OpenAirCgn/openairnode-hw/README.md

# OpenAir Hardware Plattform

This repository contains the Kicad schematics and board layouts for the
OpenAir sensor plattform, as well as the bill of materials.

Schematics

## Versions

- 1.4 changed voltage regulator footprint (IC3), to a more common pinout,
  removed MICS sensor
