OpenAirCgn/openairnode-hw/openair2_BOM.ods

 |  |  |  |  |  |  |  |  |  |  |  | Units:
 |  |  |  |  |  |  |  |  |  |  |  | 17
Qty | Reference(s) | Value | Footprint | Manuf | PN | Source | Source # | Source € | Source @ | Remarks | Cost/unit | Needed | Avail | Needed | Cost/all | Order | Cost order |  | Avail 12.1.21 |  | Order Jan 2021
 | Resistors
6 | R11, R12, R6, R8, R9, R19 | 27 | 0603 | Stackpole | RMCF0603JT27R0 | DK | RMCF0603JT27R0CT-ND | 0,0056 | 100 |  | 0,0336 | 102 | 80 | 22 | 0,1232 |  | 0
2 | R17, R18 | 220 | 0603 |  |  | avail |  |  |  |  | 0 | 34 | 999 | 0 | 0 |  | 0 |  | 999 |  | 0
1 | R2 | 1K | 0603 |  |  | avail |  |  |  |  | 0 | 17 | 999 | 0 | 0 |  | 0 |  | 999 |  | 0
2 | R26, R27 | 2K2 | 0603 |  |  | avail |  |  |  |  | 0 | 34 | 999 | 0 | 0 |  | 0 |  | 999 |  | 0
7 | R1, R3, R4, R13, R14, R15, R16 | 10K | 0603 |  |  | avail |  |  |  |  | 0 | 119 | 999 | 0 | 0 |  | 0 |  | 999 |  | 0
1 | R5 | 22K | 0603 | Stackpole | RMCF0603FT22K0 | DK | RMCF0603FT22K0CT-ND | 0,0062 | 100 |  |  |  |  |  |  |  |  | included in Noiseboard | --- |  | 0
2 | R7, R10 | 49K9 | 0603 |  |  | avail |  |  |  |  | 0 | 34 | 999 | 0 | 0 |  | 0 |  | 999 |  | 0
 | Capacitors
2 | C7, C8 | 47p | 0603 | Würth | 885012006021 | DK | 732-7764-1-ND | 0,0198 | 100 |  | 0,0396 | 34 | 80 | 0 | 0 |  | 0 |  | 100 |  | 0
1 | C6 | 10n | 0603 |  |  | avail |  |  |  |  | 0 | 17 | 999 | 0 | 0 |  | 0 |  | 999 |  | 0
5 | C1, C5, C9, C11, C13 | 0.1u | 0603 |  |  | avail |  |  |  |  | 0 | 85 | 999 | 0 | 0 |  | 0 |  | 999 |  | 0
1 | C10 | 4u7 | 0603 | Samsung | CL10A475MQ8NNNC | DK | 1276-1907-1-ND | 0,0244 | 100 |  | 0,0244 | 17 | 90 | 0 | 0 |  | 0 |  | 100 |  | 0
3 | C3, C4, C14 | 10u | 0805 | Samsung | CL21A106KOQNNNE | DK | 1276-1096-1-ND | 0,063 | 10 |  | 0,189 | 51 | 24 | 27 | 1,701 | 20 | 1,26 | Change V1.4 | 0 |  | 40
 | Inductors
1 | L1 | 2.2uH | 1008/2520 | Chilisin | BDCD002520122R2MS1 | DK | 2184-BDCD002520122R2MS1CT-ND | 0,145 | 10 |  | 0,145 | 17 | 6 | 11 | 1,595 | 10 | 1,45 | Change V1.4 | 0 |  | 15
1 | L2 | FERRITE | 0603 | Samsung | CIC10P471NC | DK | 1276-6358-1-ND | 0,024 | 10 |  | 0,024 | 17 | 0 | 17 | 0,408 | 100 | 2,4 | incl noiseboard | 50 |  | 0
 | Discrete semiconductors
1 | LED1 | LED | 0603 | Würth | 150060RS75000 | DK | 732-4978-1-ND | 0,13 | 1 |  | 0,13 | 17 | 6 | 11 | 1,43 | 20 | 2,6 | incl noiseboard | 10 |  | 0
1 | D1 | D_Schottky | SOD-123F | SMC | DSS14UTR | DK | 1655-1927-1-ND | 0,143 | 10 |  | 0,143 | 17 | 6 | 11 | 1,573 | 20 | 2,86 |  | 10 |  | 0
2 | T2, T3 | MMBT2222 | SOT23-3 | ON Semi | MMBT2222LT1G | DK | MMBT2222LT1GOSCT-ND | 0,103 | 10 |  | 0,206 | 34 | 11 | 23 | 2,369 | 30 | 3,09 |  | 30 |  | 0
1 | LED ext | LED 5mm | 5mm | Cree | C503B-RCN-CW0Z0AA1 | DK | C503B-RCN-CW0Z0AA1-ND | 0,126 | 10 |  | 0,126 | 6 | 0 | 6 | 0,756 | 10 | 1,26 | Jü only | 0 |  | 10
 | ICs
1 | IC1 | ESP-WROOM-32 | ESP-WROOM-32 | Espressif | ESP32-WROOM-32D | DK | 1904-1023-1-ND | 3,4 | 1 |  | 3,4 | 17 | 11 | 6 | 20,4 | 10 | 34 |  | 6 |  | 5
1 | IC2 | FT231XQ | QFN-20 | FTDI | FT231XQ-R | DK | 768-1128-1-ND | 1,85 | 1 |  | 1,85 | 17 | 5 | 12 | 22,2 | 15 | 27,75 |  | 5 |  | 10
1 | IC3 | SC189Z | SOT23-5 | Semtech | SC189ZSKTRT | DK | SC189ZSKCT-ND | 0,842 | 10 |  | 0,842 | 17 | 5 | 12 | 10,104 | 15 | 12,63 |  | 0 |  | 15
1 | IC5 | SI7006-A20 | SI7006-A20 | Silicon Labs | SI7006-A20-IM1R | DK | 336-4348-1-ND | 2,36 | 1 |  | 2,36 | 11 | 2 | 9 | 21,24 | 10 | 23,6 | K only | 0 |  | 12
1 | IC6 | RFM95W | RFM95W-SMD | RF Solutions | RFM95W-868S2 | soselectronic |  |  |  |  | 0 | 11 | 2 | 9 | 0 |  | 0 | K only soselectronic | 3 | +2 915MHz? | 10
1 | U1 | MIC20XX | SOT23-5 | Microchipl | MIC2004-1.2YM5-TR | DK | 576-3462-1-ND | 0,67 | 10 |  | 0,67 | 6 | 4 | 2 | 1,34 | 5 | 3,35 | Jü only, maybe some K | --- |  | 10
 | Mechanical
2 | BTN1, BTN2 | RESET, USER | CK-PTS830 | C&K | PTS830GM140 SMTR LFS | DK | CKN10587CT-ND | 0,434 | 10 |  | 0,868 | 34 | 17 | 17 | 7,378 | 50 | 21,7 | incl noiseboard | 15 |  | 10
1 | USB1 | USB | USB-MICRO-B | Amphenol | 10104110-0001LF | DK | 609-4052-1-ND | 0,582 | 10 |  | 0,582 | 17 | 23 | 0 | 0 | 30 | 17,46 | Re-stock, incl Noiseboard | 20 |  | 0
1 | ANT1 | CONN_2 | U-FL | TE | 1909763-1 | DK | A118077CT-ND | 0,413 | 10 |  | 0,413 | 11 | 2 | 9 | 3,717 | 10 | 4,13 | K only | 3 |  | 10
1 | P1 | PM | HEADER-1x07-2.5-JST-XH | JST | B7B-XH-A(LF)(SN) | DK | 455-2252-ND | 0,276 | 10 |  | 0,276 | 6 | 0 | 6 | 1,656 | 10 | 2,76 | Jü only | ---
2 | P2, P3 | Module conn | HEADER-1x08-1.27-ZZ-POL | TE | 7-215079-8 | DK | A99471CT-ND | 0,995 | 10 |  | 1,99 | 34 | 13 | 21 | 20,895 | 25 | 24,875 |  | 15 |  | 0
1 | P4 | FAN | HEADER-1x03-2.54 | TE | 640456-3 | DK | A19470-ND | 0,107 | 10 |  | 0,107 | 6 | 8 | 0 | 0 | 0 | 0 | Jü only | ---
1 | P5 | PWR | HEADER-1x04-2.5-JST-XH | JST | B3B-EH-A(LF)(SN) | DK | 455-1612-ND | 0,145 | 10 |  | 0,145 | 17 | 0 | 17 | 2,465 | 20 | 2,9 |  | 0 |  | 20
1 | P5 plug | Housing for PWR |  | JST | EHR-4 | DK | 455-1002-ND | 0,066 | 1 |  | 0,066 | 6 | 0 | 6 | 0,396 | 7 | 0,462 | Jü only | 0 |  | 20
4 | P5 contacts |  |  | JST | SEH-001T-P0.6 | DK | 455-1042-1-ND | 0,0219 | 100 |  |  |  |  |  |  |  |  |  |  |  | 100
2 | P1 plug | PM plug (both sides) |  | JST | XHP-7 | DK | 455-2269-ND | 0,12 | 10 |  | 0,24 | 34 | 0 | 34 | 4,08 | 20 | 2,4 | ??? Jü only? Also on board? |  |  | 0
18 | P1, P5 contacts | PM / PWR plug contact |  | JST | SXH-001T-P0.6 | DK | 455-1135-1-ND | 0,0336 | 50 |  | 0,6048 | 306 | 0 | 306 | 10,2816 | 100 | 3,36 | ??? Jü only? Also on board? |  |  | 0
1 | P4 plug | Housing for fan plug |  | Molex | 50291558 | DK | WM22811-ND | 0,09 | 10 |  | 0,09 | 0 | 0 | 0 | 0 | 0 | 0 | Included in fan |  |  | 0
1 | ANT1 ant | 868 MHz u.fl antenna |  | Molex | 2111400100 | DK | WM25681-ND | 1,86 | 10 |  | 1,86 | 11 |  | 10 | 18,6 | 0 | 0 | ??? Whip antenna? | 7+4 |  | 0
1 | Stecker für P2 / P3 |  |  | TE | 215083-8 | DK | A111108CT-ND | 0,55 | 10 |  |  |  |  |  |  |  |  |  | 15 |  | 0
 |  | JST EH 4 |  | JST
 |  | JST EH 4
 |  | JST EH
 | Other
1 |  | SDS011 |  |  |  | Reichelt
1 |  | Fan |  | ITR | ITR-XR2 | Conrad | 649911 - 62 | 5,03
1 |  | Power jack | 5.5x2.1 locking | Switchcraft | L722A | DK | SC1151-ND | 3,33 | 1 |  |  |  |  |  |  | 5 | 16,65
1 |  | Power plug (5.5x2.5 – first 5) | 5.5x2.5 locking | Switchcraft | 761KS15 | DK | SC1382-ND | 4,49 | 1 |  |  |  |  |  |  | 5 | 22,45
1 |  | Power plug | 5.5x2.1 locking | Switchcraft | 767KS15 | DK | SC1388-ND | 5,58 | 1
 |  |  |  |  |  |  |  |  |  |  | 17,4244 |  |  |  | 154,7078 |  | 212,947
