OpenAirCgn/openairnode-hw/(commit log)

2017-09-06 First complete layout
    [openair2.kicad_pcb, openair2.sch]
2017-09-07 Changed MISO/MOSI, put GPIO35 to ext connector
    [openair2.kicad_pcb, openair2.sch]
2017-09-07 Added artwork, last pinout changes
    [openair2.kicad_pcb, openair2.sch]
2017-10-26 Swapped Vox and Vred, bumped version to 1.1
    [openair2.kicad_pcb, openair2.sch]
2019-01-24 Upodates to version 1.2
    [openair2.kicad_pcb, openair2.sch]
2019-06-11 Changed PAM2305 to SC189 due to part availability
    [openair2.kicad_pcb, openair2.sch]
2019-06-12 In the middle of improving fan PWM sensing
    [openair2.kicad_pcb, openair2.sch]
2019-08-29 Minor changes
    [openair2.kicad_pcb, openair2.sch, openair2_BOM.ods]
2019-09-02 BOM update
    [openair2_BOM.ods]
2020-09-12 plots of schematics, README
2021-01-15 Changed buck regulator, removed MICS sensor, removed EEPROM, full IO connectivity to module connectors, BOM update
    [openair2.kicad_pcb, openair2.sch, openair2_BOM.ods]
2021-01-15 board update
    [openair2.kicad_pcb]
2021-01-19 Fixed pour spacing, generated 1.4 Gerber files
    [openair2.kicad_pcb]
2021-01-19 added link to proper tag
    [openair2-panelized.kicad_pcb]
2021-01-19 more room for antenna overhang
    [openair2-panelized.kicad_pcb]
2021-03-09 appended part numbers
    [openair2.sch]
2021-03-11 bom changes
    [openair2.sch]
2021-03-25 mouser and digi partnos
    [openair2.sch]
2021-03-25 DNP R3
    [openair2.sch]
2021-03-26 R3 note, README, deleted CAM data (added as a GH release)
    [openair2.sch]
